vincentaulia/Remote-Monitoring-Hardware/BOM - Remote Monitoring Hardware.xlsx

Part | Value | Package | Description | Distributor Part Number | Manufacturer Part Number | Quantity per Build | Price per Quantity | Price per Build | July 5 BOM CHECK
CASE | 3.29 x 2.42 x 1.00 in. / 83.57 x 61.47 x 25.40 mm. / 0.14 lbs | LP-21P LP | LP-21P LP Series ABS Plastic Enclosure for Electronics | LP-21PMBT | LP-21PMBT | 1 | 2.98 | 2.98
C6 | 100nF | C0805 | 0.1µF ±10% 6.3V Ceramic Capacitor X7R 0805 (2012 Metric) | 399-9155-1-ND | C0805C104K9RACTU | 2 | 0.19 | 0.38 | y
C2 | 1nF | C0805 | 1000pF ±10% 10V Ceramic Capacitor X7R 0805 (2012 Metric) | 399-9153-1-ND | C0805C102K8RACTU | 1 | 0.14 | 0.14 | y
C3, C4 | 12pF | C0805 | 12pF ±5% 50V Ceramic Capacitor C0G, NP0 0805 (2012 Metric) | 311-1100-1-ND | CC0805JRNPO9BN120 | 2 | 0.14 | 0.28 | y
C5, C10, C11 | 10uF/10V (C5) | C0805 | 10µF ±10% 10V Ceramic Capacitor X7R 0805 (2012 Metric) | 311-1879-1-ND | CC0805KKX7R6BB106 | 3 | 0.37 | 1.11 | y
C9 | 0.01uF | C0805 | 10000pF ±10% 10V Ceramic Capacitor X7R 0805 (2012 Metric) | 732-8021-1-ND | 885012207011 | 1 | 0.4 | 0.4 | y
B1 | 2/3A | 2/3A | HOLDER BATTERY 2/3A DELPHI EQUAL | 6S-2-3A-ND | 6S-2-3A | 1 | 0.84 | 0.84
 |  | 2/3A | LST17330 Saft Lithium Battery | LST17330 | LST17330 | 1 | 13.12 | 13.12
D1, D2 | 1N4148 | SOD323-R | Diode Standard 75V 150mA Surface Mount SOD-323 | 1N4148WS-E3-08CT-ND | 1N4148WS-E3-08 | 2 | 0.35 | 0.7 | y
IC1 | MSP430G2553 IC | TSSOP-20 | IC MCU 16BIT 16KB FLASH 20TSSOP | 296-33465-5-ND | MSP430G2553IPW20 | 1 | 3.6 | 3.6 | y
IC3 | Xbee S3 Socket | XBEE-LONGPAD |  |  | PRT-08272 | 2 | 1 | 2 | y
 | Xbee S3 Module |  | RF TXRX MOD 802.15.4 TRACE ANT | 602-1557-ND | XB24CZ7PIT-004 | 1 | 23.49 | 23.49 | y
IC4 | MAX31855T | SOIC8 | IC CONV THERMOCOUPLE-DGTL 8SOIC | MAX31855TASA+-ND | MAX31855TASA+ | 1 | 7 | 7 | y
JP1, JP2, 3, 4, 5 |  |  | CONN JUMPER SHORTING TIN | S9000-ND | STC02SYAN | 5 | 0.19 | 0.95
J3, J4, J5A |  | SCREWTERMINAL-3.5MM-2 |  |  |  | 3 | 0.55 | 1.65 | y
J5B |  | PCC-SMP | Thermocouple Connector, PCB, Miniature, Type T, Socket | 01H0906 (Newark) | PCC-SMP-T/N | 1 | 3.08 | 3.08
J6 |  | MA04-1 |  | 609-3271-ND | 68001-104HLF | 1 | 0.41 | 0.41 | y
J7 |  | MA06-1 | CONN HEADER 6POS .100 STR 30AU | 609-3272-ND | 68001-106HLF | 1 | 0.46 | 0.46 | y
L1, L2 |  | 402 | FERRITE BEAD 120 OHM 0402 1LN | 490-4000-1-ND | BLM15HB121SN1D | 2 | 0.27 | 0.54 | y
LED3, 4, 7 | Green | LED_1206 | LED GREEN CLEAR 2SMD R/A | 1516-1073-1-ND | QBLP615-IG | 3 | 0.72 | 2.16 | y
LED5 | Red | LED_1206 | LED RED CLEAR 2SMD R/A | 1516-1076-1-ND | QBLP615-R | 1 | 0.59 | 0.59 | y
Q1 | 32.768kHz | SMD-2X6 | CRYSTAL 32.7680KHZ 12.5PF SMD | 535-12051-1-ND | AB26TRQ-32.768KHZ-T | 1 | 0.59 | 0.59 | y
R2 | 47k | R0805 | RES SMD 47K OHM 5% 1/8W 0805 | 311-47KARCT-ND | RC0805JR-0747KL | 1 | 0.15 | 0.15 | y
R8, R9 | 10k | R0805 | RESISTOR, European symbol | 311-10KARCT-ND | RC0805JR-0710KL | 2 | 0.15 | 0.3 | y
R10, R11, R12, R13 | 1k | R0805 | RESISTOR, European symbol | 311-1.0KARCT-ND | RC0805JR-071KL | 4 | 0.15 | 0.6 | y
S3 |  | Mini Pushbutton SMD | Mini Pushbutton Switch - SMD | COM-08720 | COM-08720 | 1 | 1.19 | 1.19 | y
 |  |  |  | total |  |  |  | 68.71
 |  |  |  |  | [
