vincentaulia/Remote-Monitoring-Hardware/Remote Monitoring Hardware.brd

## EAGLE design Remote Monitoring Hardware.brd (2017-09-20)

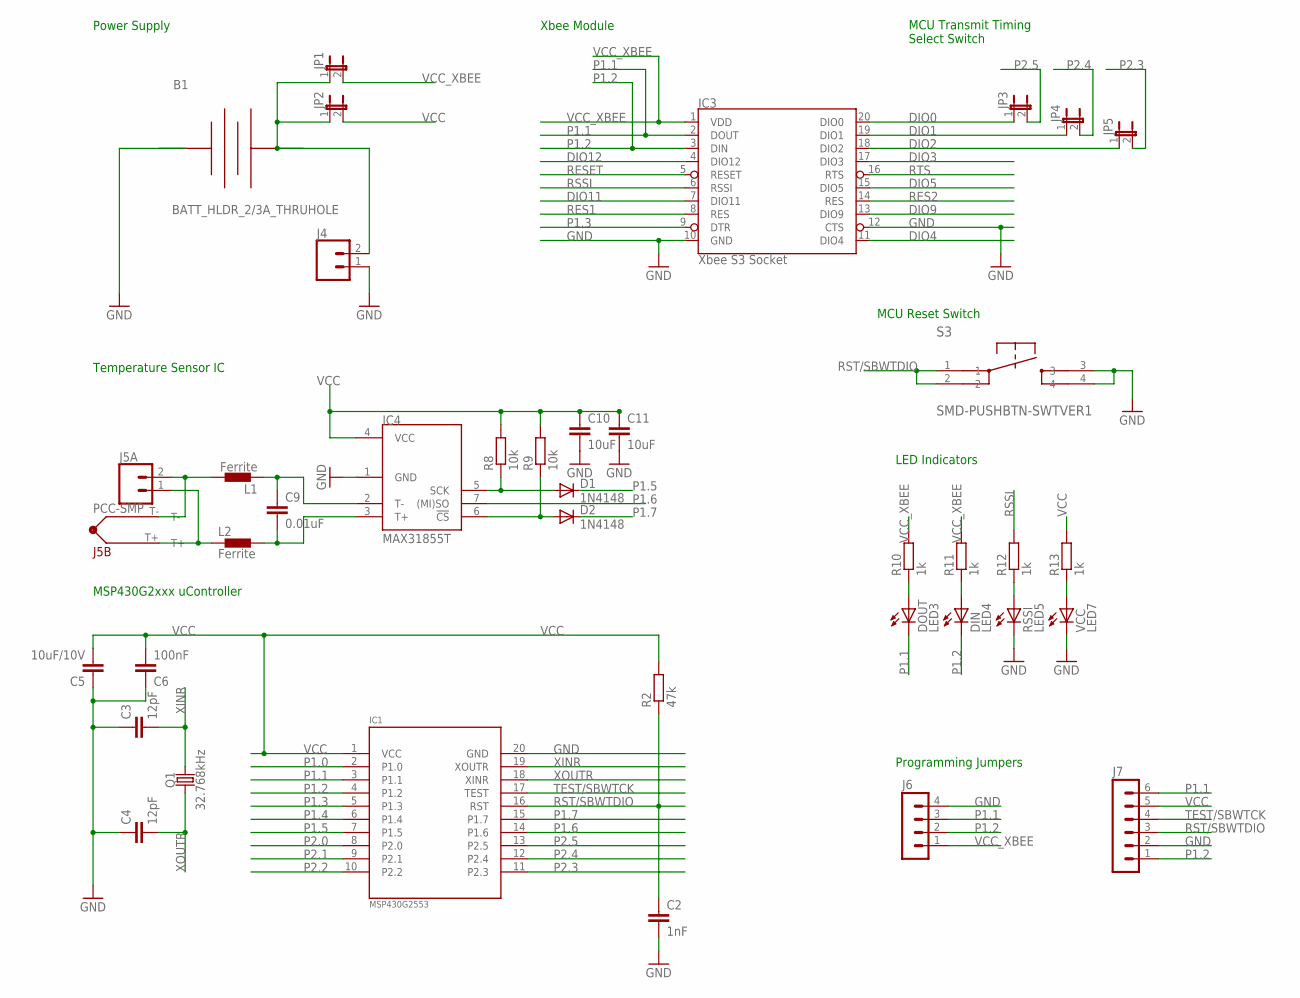
[picture p1: schematic Remote Monitoring Hardware.sch]

Parts:
B1: BATT_HLDR_2/3A_THRUHOLE
C2: 1nF; C0805
C3, C4: 12pF; C0805
C5: 10uF/10V; C0805
C6: 100nF; C0805
C9: 0.01uF; C0805
C10, C11: 10uF; C0805
D1, D2: 1N4148; SOD323-R
DIN: LED4; SML0805
DOUT: LED3; SML0805
IC1: MSP430G2553; MSP430G2553IPW20
IC3: Xbee S3 Socket; XBEE-LONGPAD
IC4: MAX31855T; SOIC8
J4, J5A: CONN_023.5MM; SCREWTERMINAL-3.5MM-2
J5B: PCC-SMP
J6: MA04-1
J7: MA06-1
JP1, JP2, JP3, JP4, JP5: JUMPER-2PTH; 1X02
L1, L2: Ferrite; 0402
Q1: 32.768kHz; CRYSTAL-SMD-2X6-CYL
R2: 47k; R0805
R8, R9: 10k; R0805
R10, R11, R12, R13: 1k; R0805
RSSI: LED5; SML0805
S3: SMD-PUSHBTN-SWTVER1; KPT-1187B
VCC: LED7; SML0805

Connections:
1: D1.A, IC4.5 (SCK), R8.1
2: D2.A, IC4.6 (!CS), R9.1
DIO0: IC3.20 (DIO0), JP3.1
DIO1: IC3.19 (DIO1), JP4.1
DIO2: IC3.18 (DIO2), JP5.1
DIO3: IC3.17 (DIO3)
DIO4: IC3.11 (DIO4)
DIO5: IC3.15 (DIO5)
DIO9: IC3.13 (DIO9)
DIO11: IC3.7 (DIO11)
DIO12: IC3.4 (DIO12)
GND: B1.NEG, C2.2, C3.1, C4.1, C5.1, C6.1, C10.2, C11.2, IC1.20 (GND), IC3.10 (GND), IC3.12 (CTS), IC4.1 (GND), J4.1, J6.4, J7.2, RSSI.C, S3.3, S3.4, VCC.C
unnamed: B1.POS, J4.2, JP1.1, JP2.1
unnamed: DOUT.A, R10.1
unnamed: DIN.A, R11.1
unnamed: R12.1, RSSI.A
unnamed: C9.1, IC4.2 (T-), L1.1
unnamed: C9.2, IC4.3 (T+), L2.2
unnamed: J5A.2, J5B.T-, L1.2
unnamed: J5A.1, J5B.T+, L2.1
unnamed: R13.1, VCC.A
P1.0: IC1.2 (P1.0)
P1.1: DOUT.C, IC1.3 (P1.1), IC3.2 (DOUT), J6.3, J7.6
P1.2: DIN.C, IC1.4 (P1.2), IC3.3 (DIN), J6.2, J7.1
P1.3: IC1.5 (P1.3), IC3.9 (DTR)
P1.4: IC1.6 (P1.4)
P1.5: D1.C, IC1.7 (P1.5)
P1.6: IC1.14 (P1.6), IC4.7 ((MI)SO)
P1.7: D2.C, IC1.15 (P1.7)
P2.0: IC1.8 (P2.0)
P2.1: IC1.9 (P2.1)
P2.2: IC1.10 (P2.2)
P2.3: IC1.11 (P2.3), JP5.2
P2.4: IC1.12 (P2.4), JP4.2
P2.5: IC1.13 (P2.5), JP3.2
RES1: IC3.8 (RES)
RES2: IC3.14 (RES)
RESET: IC3.5 (RESET)
RSSI: IC3.6 (RSSI), R12.2
RST/SBWTDIO: C2.1, IC1.16 (RST), J7.3, R2.1, S3.1, S3.2
RTS: IC3.16 (RTS)
TEST/SBWTCK: IC1.17 (TEST), J7.4
VCC: C5.2, C6.2, C10.1, C11.1, IC1.1 (VCC), IC4.4 (VCC), J7.5, JP2.2, R2.2, R8.2, R9.2, R13.2
VCC_XBEE: IC3.1 (VDD), J6.1, JP1.2, R10.2, R11.2
XINR: C3.2, IC1.19 (XOUTR), Q1.X2 (2)
XOUTR: C4.2, IC1.18 (XINR), Q1.X1 (1)

Notes on the sheet:
Power Supply
Xbee Module
LED Indicators
Temperature Sensor IC
MSP430G2xxx uController
MCU Reset Switch
Programming Jumpers
MCU Transmit Timing Select Switch

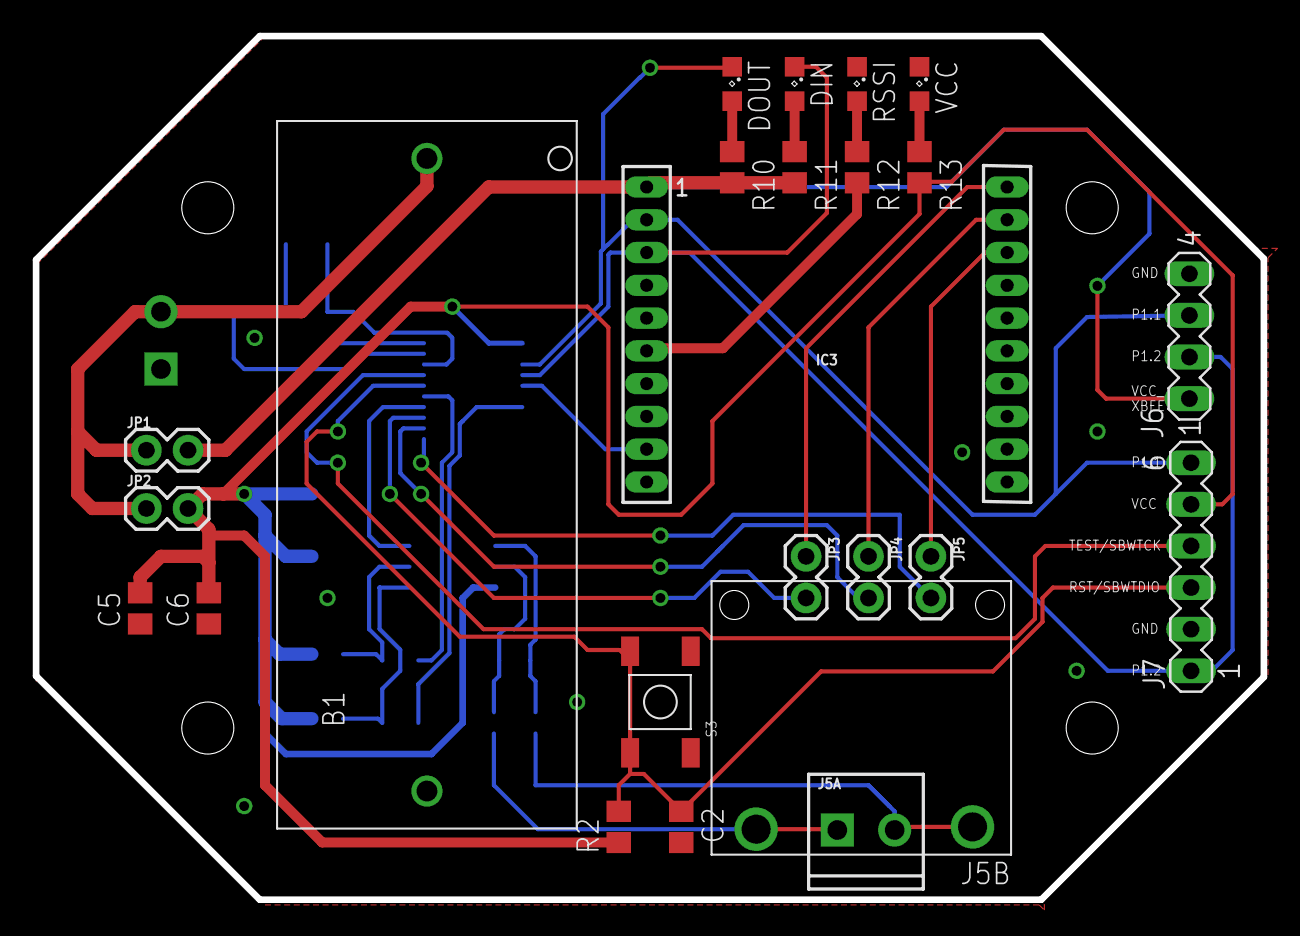
[picture p2: board Remote Monitoring Hardware.brd from above]

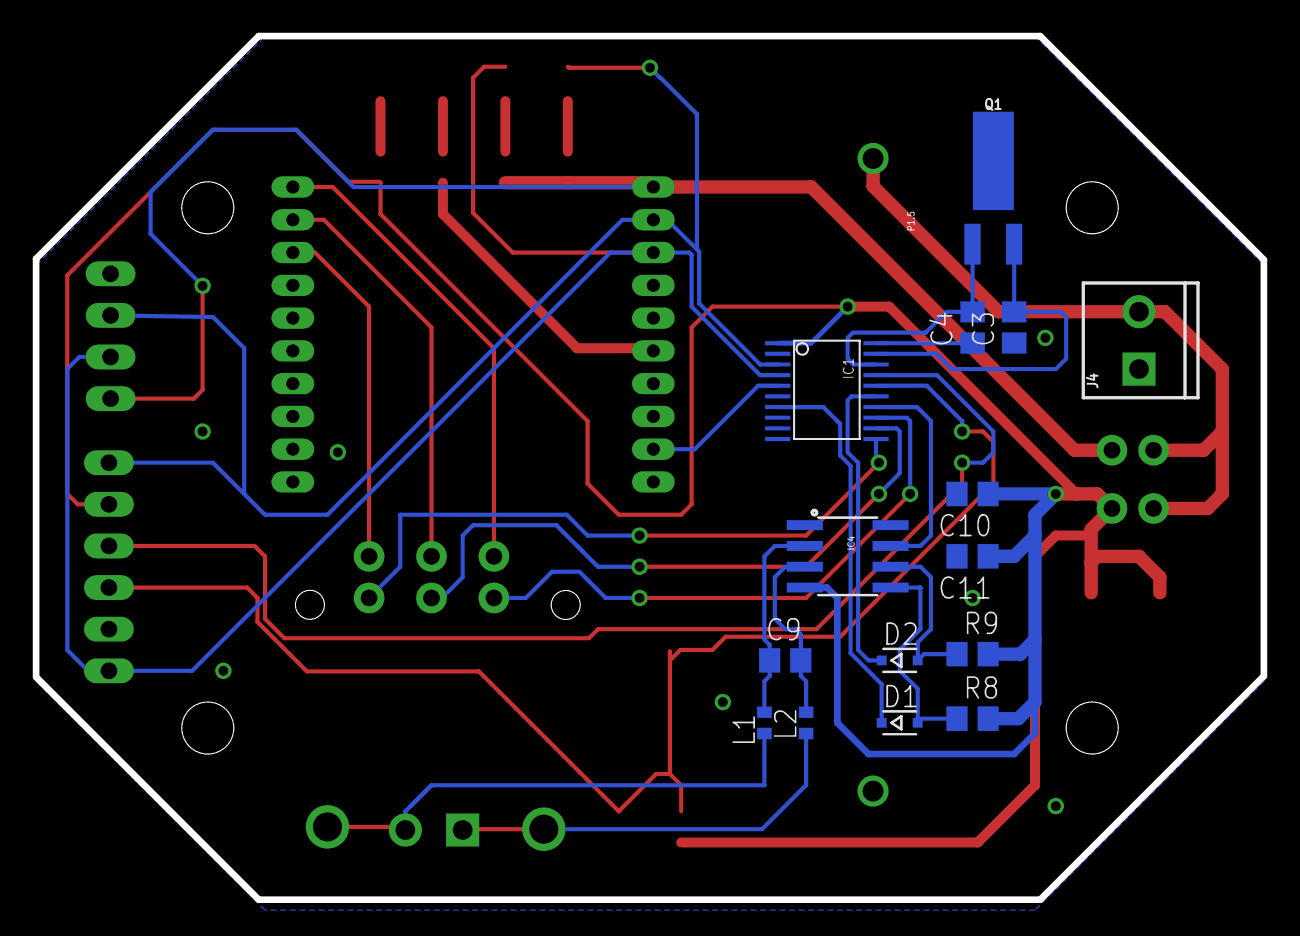
[picture p3: board Remote Monitoring Hardware.brd from below]

Board: 2 copper layers, 74.9 x 52.7 mm, 39 parts (15 on the bottom side), 31 nets.
