vincentaulia/Remote-Monitoring-Hardware/(commit log)

2017-09-20 initial project version
    [BOM - Remote Monitoring Hardware.xlsx, Board - Remote Monitoring Hardware.brd, Schematics - Remote Monitoring Hardware.sch]
2017-09-20 board and schematics update May 25 2017
    [Board - Remote Monitoring Hardware.brd, Schematics - Remote Monitoring Hardware.sch]
2017-09-20 Added BOM + brd & sch changes Aug 28 2017
    [BOM - Remote Monitoring Hardware.xlsx, Board - Remote Monitoring Hardware.brd, Schematics - Remote Monitoring Hardware.sch]
2017-09-20 brd & sch changes Sept 12 2017
    [Board - Remote Monitoring Hardware.brd, Schematics - Remote Monitoring Hardware.sch]
2017-09-20 brd sch BOM changes Sept 20 2017
    [BOM - Remote Monitoring Hardware.xlsx, Board - Remote Monitoring Hardware.brd, Schematics - Remote Monitoring Hardware.sch]
2017-09-20 larger msp430 programmer pins , new eagle project setup
    [Remote Monitoring Hardware.brd, Remote Monitoring Hardware.sch]
2017-09-20 revised bom for larger programming pin
    [BOM - Remote Monitoring Hardware.xlsx]
